frankgu968/GenX_steering_wheel/docs/Schematic.pdf

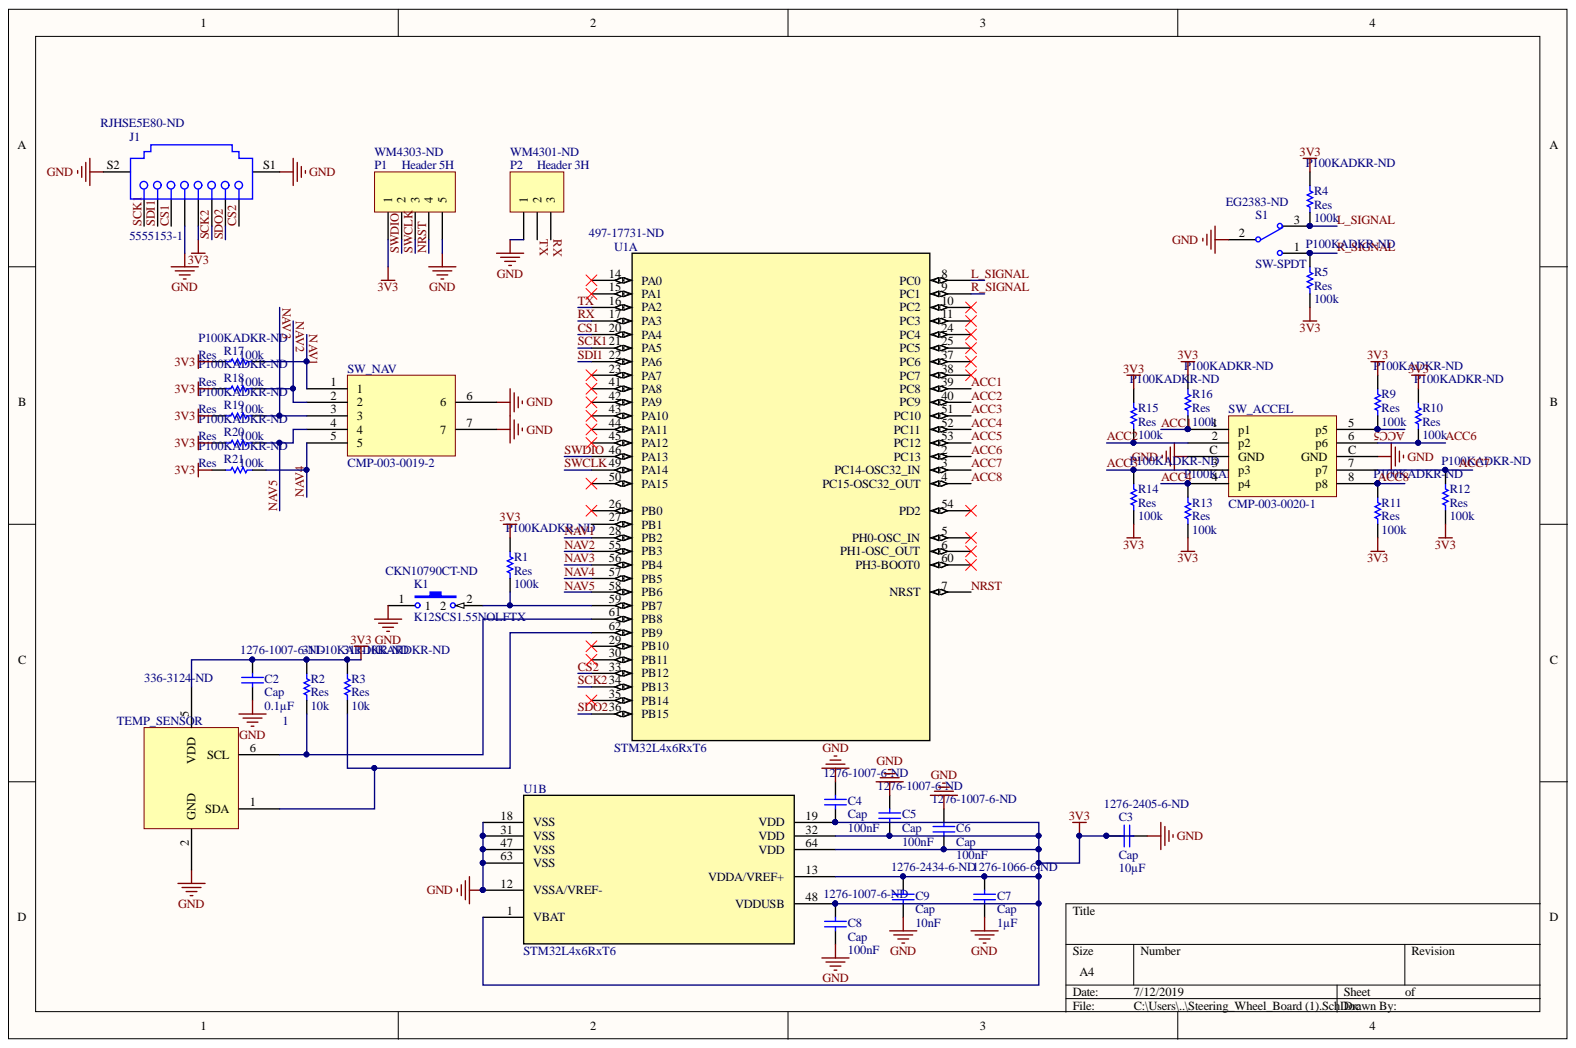
[picture p1: page 1]

Numbe r | R evision

: 7/12/2019 | She et of
File : C:\Use rs\. .\Ste e ring_Whe el_Board (1) . S chDDocra | wn By:

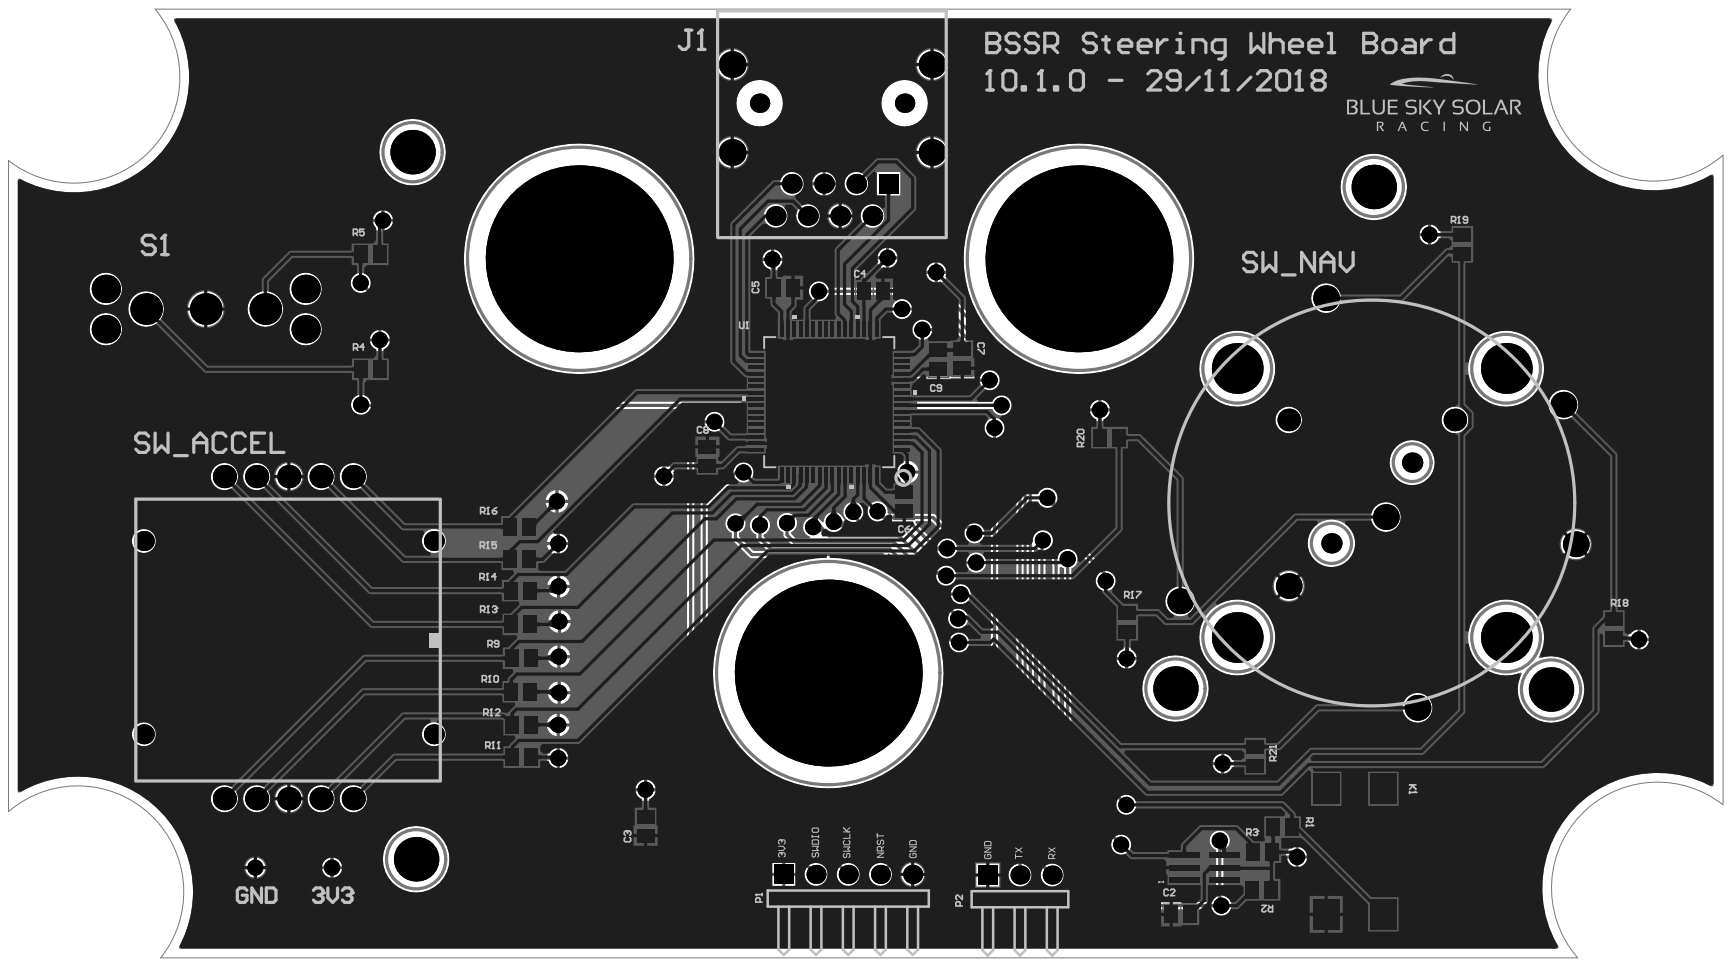
[picture p2: page 2]
