frankgu968/GenX_steering_wheel/code/GenX_SteeringWheel.ioc

Mcu.UserName=STM32L4A6RGTx
PA0.GPIO_Label=D_PAD_A
PA0.Signal=S_TIM2_CH1
PA1.GPIO_Label=D_PAD_B
PA1.Signal=S_TIM2_CH2
PA2.Signal=USART2_TX
PA3.Signal=USART2_RX
PA4.Signal=SPI1_NSS
PA5.Signal=SPI1_SCK
PA6.Signal=SPI1_MISO
PB12.Signal=SPI2_NSS
PB13.Signal=SPI2_SCK
PB15.Signal=SPI2_MOSI
PB5.GPIO_Label=D_PAD_4
PB5.Signal=GPIO_Input
PB6.GPIO_Label=D_PAD_5
PB6.Signal=GPIO_Input
PB7.GPIO_Label=RADIO
PB7.Signal=GPIO_Input
PB8.GPIO_Label=D_TEMP_SCL
PB8.Signal=I2C1_SCL
PB9.GPIO_Label=D_TEMP_SDA
PB9.Signal=I2C1_SDA
PC0.GPIO_Label=L_SIGNAL
PC0.Signal=GPIO_Input
PC1.GPIO_Label=R_SIGNAL
PC1.Signal=GPIO_Input
PC10.GPIO_Label=ACC_3
PC10.Signal=GPIO_Input
PC11.GPIO_Label=ACC_4
PC11.Signal=GPIO_Input
PC12.GPIO_Label=ACC_5
PC12.Signal=GPIO_Input
PC13.GPIO_Label=ACC_6
PC13.Signal=GPIO_Input
PC8.GPIO_Label=ACC_1
PC8.Signal=GPIO_Input
PC9.GPIO_Label=ACC_2
PC9.Signal=GPIO_Input
PD2.GPIO_Label=D_PAD_1
PD2.Signal=GPIO_Input
