frankgu968/GenX_steering_wheel/code/Inc/main.h

#define ACC_6_Pin GPIO_PIN_13
#define ACC_6_GPIO_Port GPIOC
#define ACC_7_Pin GPIO_PIN_14
#define ACC_7_GPIO_Port GPIOC
#define ACC_8_Pin GPIO_PIN_15
#define ACC_8_GPIO_Port GPIOC
#define L_SIGNAL_Pin GPIO_PIN_0
#define L_SIGNAL_GPIO_Port GPIOC
#define R_SIGNAL_Pin GPIO_PIN_1
#define R_SIGNAL_GPIO_Port GPIOC
#define D_PAD_A_Pin GPIO_PIN_0
#define D_PAD_A_GPIO_Port GPIOA
#define D_PAD_B_Pin GPIO_PIN_1
#define D_PAD_B_GPIO_Port GPIOA
#define ACC_1_Pin GPIO_PIN_8
#define ACC_1_GPIO_Port GPIOC
#define ACC_2_Pin GPIO_PIN_9
#define ACC_2_GPIO_Port GPIOC
#define ACC_3_Pin GPIO_PIN_10
#define ACC_3_GPIO_Port GPIOC
#define ACC_4_Pin GPIO_PIN_11
#define ACC_4_GPIO_Port GPIOC
#define ACC_5_Pin GPIO_PIN_12
#define ACC_5_GPIO_Port GPIOC
#define D_PAD_1_Pin GPIO_PIN_2
#define D_PAD_1_GPIO_Port GPIOD
#define D_PAD_2_Pin GPIO_PIN_3
#define D_PAD_2_GPIO_Port GPIOB
#define D_PAD_3_Pin GPIO_PIN_4
#define D_PAD_3_GPIO_Port GPIOB
#define D_PAD_4_Pin GPIO_PIN_5
#define D_PAD_4_GPIO_Port GPIOB
#define D_PAD_5_Pin GPIO_PIN_6
#define D_PAD_5_GPIO_Port GPIOB
#define RADIO_Pin GPIO_PIN_7
#define RADIO_GPIO_Port GPIOB
#define D_TEMP_SCL_Pin GPIO_PIN_8
#define D_TEMP_SCL_GPIO_Port GPIOB
#define D_TEMP_SDA_Pin GPIO_PIN_9
#define D_TEMP_SDA_GPIO_Port GPIOB
