frankgu968/GenX_steering_wheel/(commit log)

2019-07-15 WIP(read encoder)
2019-07-15 accelerometer and all serializers work
2019-07-17 i2c speed changed
